nmulkey3/JunctionBox_42PinConversion/Docs/Requirements 42pin to 19pin converter board.pptx

42-Pin Junction Box Harness

19-Pin
A Receptacle

Signal
Conditioning
Board

R TR-A

R CL-A

R TR-B

R CL-B

R TR-C

R CL-C

CN3 – Molex 12pins
To 19-pin

Relay
FI-A

Relay
FI-B

Relay
FI-C

CN2 – 3pins Large

CN1 – Molex 12pins
From 42-pin

19-Pin
B Receptacle

19-Pin
C Receptacle

Part#

12V to 24V Converter

Vishay AC07000001502JAC00,
15kΩ, 5%, 7W

42-Pin Receptacle

## Slide 2

42-Pin Junction Box Harness Pin Map

42-Pin Connector | SS Junction Box Pins
1 | 19A-L
2 | CN1-2
3 | CN1-1
4 | CN1-4
5 | CN1-3
6 | CN1-6
7 | CN1-5
8 | 19B-L
9 | 19C-L
10 | CN1-10
11 | CN1-11
12 | CN1-7
13 | CN1-8
14 | CN1-9
15 | 19A-P, 19B-P, 19C-P
16 | 19C-M
17 | 19B-M
18
19
20
21 | 19A-A
22 | 19A-M
23
24
25 | CN1-11
26
27 | 19A-C, 19B-C, 19C-C
28 | 19B-A
29
30 | 19A-N
31 | 19B-N
32 | 19C-N
33 | 19A-N
34 | 19B-N
35 | 19C-A
36 | 19A-F
37 | 19B-F
38 | 19C-F
39 | 19C-N
40 | 19A-E
41 | 19B-E
42 | 19C-E

CN3 Pin | SS Junction Box Pins
1 | 19A-H
2 | 19A-G
3 | 19B-H
4 | 19B-G
5 | 19C-H
6 | 19C-G
7 | 19A-R
8 | 19B-R
9 | 19C-R
10 | 19A-J, 19B-J, 19C-J
11 | 19A-K, 19B-K, 19C-K
12

## Slide 3

Signal Conditioning Board Pin Outs

Pin | Signal
1 | Trip 1 (155V)
2 | Close 1 (155V)
3 | Trip 2 (155V)
4 | Close 2 (155V)
5 | Trip 3 (155V)
6 | Close 3 (155V)
7 | Fault Ind A (12V)
8 | Fault Ind B (12V)
9 | Fault Ind C (12V)
10 | 12V DC Power
11 | Gnd
12

CN1

Pin | Signal
1 | 12V DC Power
2 | Gnd
3 | 24V DC Power

CN2

Pin | Signal
1 | Trip A (24V)
2 | Close A (24V)
3 | Trip B (24V)
4 | Close B (24V)
5 | Trip C (24V)
6 | Close C (24V)
7 | Fault Ind A (24V)
8 | Fault Ind B (24V)
9 | Fault Ind C (24V)
10 | 24V DC Power
11 | Gnd
12

CN3

CN2-3 to CN3-10
Make a very wide trace to handle 5A continuous
