nmulkey3/JunctionBox_42PinConversion/Docs/Datasheets/Enclosure LP35 PCB Template.png

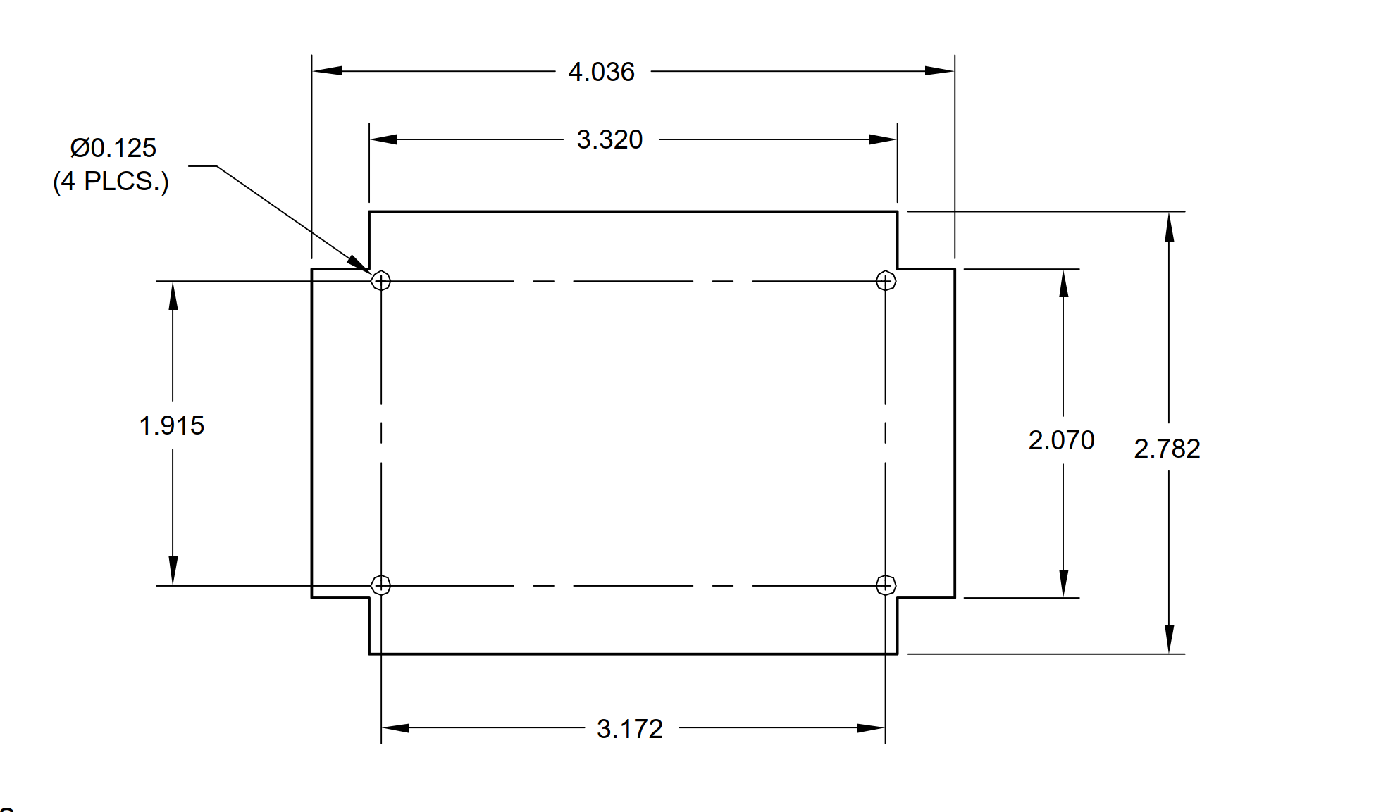
Docs/Datasheets/Enclosure LP35 PCB Template.png
