nmulkey3/JunctionBox_42PinConversion/Builds/Rev(-) 2021Nov22/42JxBx_Proto_eBOM_11082021.xlsx

42JxBx_Proto |  | Approved by Nick Mulkey | Approved on 11/08/2021 | Approved for PCBA 42JxBx_Proto Rev(-) 08Nov2021
Designator | Comment | Description | Footprint | Manufacturer | PartNumber | Quantity | Temp | Voltage | Power | PartNumber-CM | Alternate Allowed
C1, C2, C5, C7, C9, C11 | 100nF | CAP CER 10% 0603 | C0603N | AVX Corporation | 06035C104KAZ2A | 6
C3, C4, C6, C8, C10, C12 | 0.012uF | CAP CER 10% 0805 | C0805K | KEMET | C0805C123K5RACTU | 6
CN1, CN3 | 0039299183 | Connector Header Through Hole 18 position 0.165" (4.20mm) | 0039299183 | Molex | 0039299183 | 2
CN2 | 15-31-1036 | 3 Pin power connector | Molex_15-31-1036_0 | Molex | 15-31-1036 | 1
D1, D2, D3 | S1A-13-F |  | Micro_Commercial_DO-214AC_MFG |  | S1A-13-F | 3
K1, K2, K3 | DS2Y-S-DC24V |  | Panasonic_DS2Y-S-DC24V_0 |  | DS2Y-S-DC-24V-H350 | 3
R1, R2, R3, R4, R5, R6, R7, R8, R9, R10, R11,R12 | 10k | RES SMD 1/10W 0603 1%, RES SMD 1/10W 0603 0.1% | R0603N | Panasonic Electronic Components | ERA-8AEB103V | 12
R13, R14, R15, R16, R17, R18 | AC07000001502JAC00 |  | AC07000001502JAC00 |  | AC07000001502JAC00 | 6
U1, U2, U3, U4, U5, U6 | FOD817DSD | OPTOISOLATOR 5KV TRANSISTOR 4SMD | 4-SMD GullWing |  | FOD817DSD | 6
Do Not Populate
RTD2 is an Alternate to RTD1, but with a different Package. Only Populate RTD1 or RTD2, never both
Part Provided
Alternate Part
Updated Since Last Release
Special Install Instructions
