nmulkey3/JunctionBox_42PinConversion/Docs/Datasheets/Board Outline Enclosure - Potting Enclosure Body BX-3308BMB v1.dxf

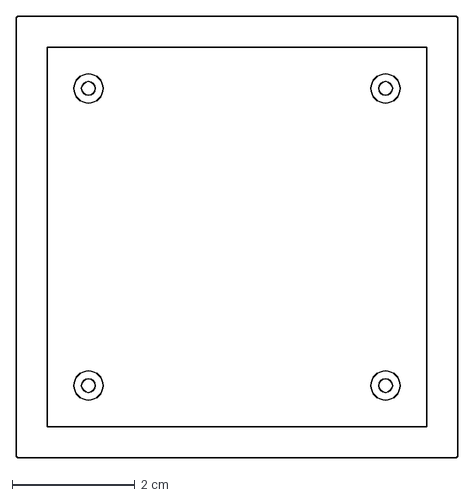
[picture p2: CAD file, 2021-11-09]
Docs/Datasheets/Board Outline Enclosure - Potting Enclosure Body BX-3308BMB v1.dxf
7.20 x 7.20 cm
