nmulkey3/JunctionBox_42PinConversion/Docs/Datasheets/Enclosure - LP35 PCB Template v1.dxf

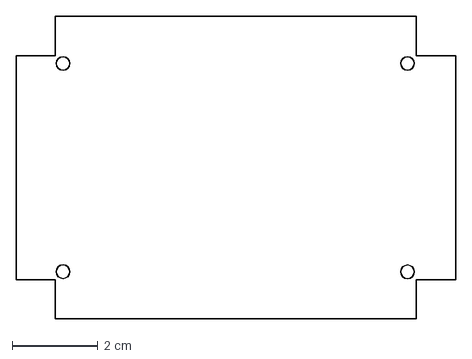
[picture p3: CAD file, 2021-11-09]
Docs/Datasheets/Enclosure - LP35 PCB Template v1.dxf
10.3 x 7.07 cm
