nmulkey3/JunctionBox_42PinConversion/(list of files, cad)

Other CAD files:
Docs/Datasheets/Enclosure - LP35 PCB Template v1.dwg
