nmulkey3/JunctionBox_42PinConversion/Junction Bo 42Pin Conv 2.pdf

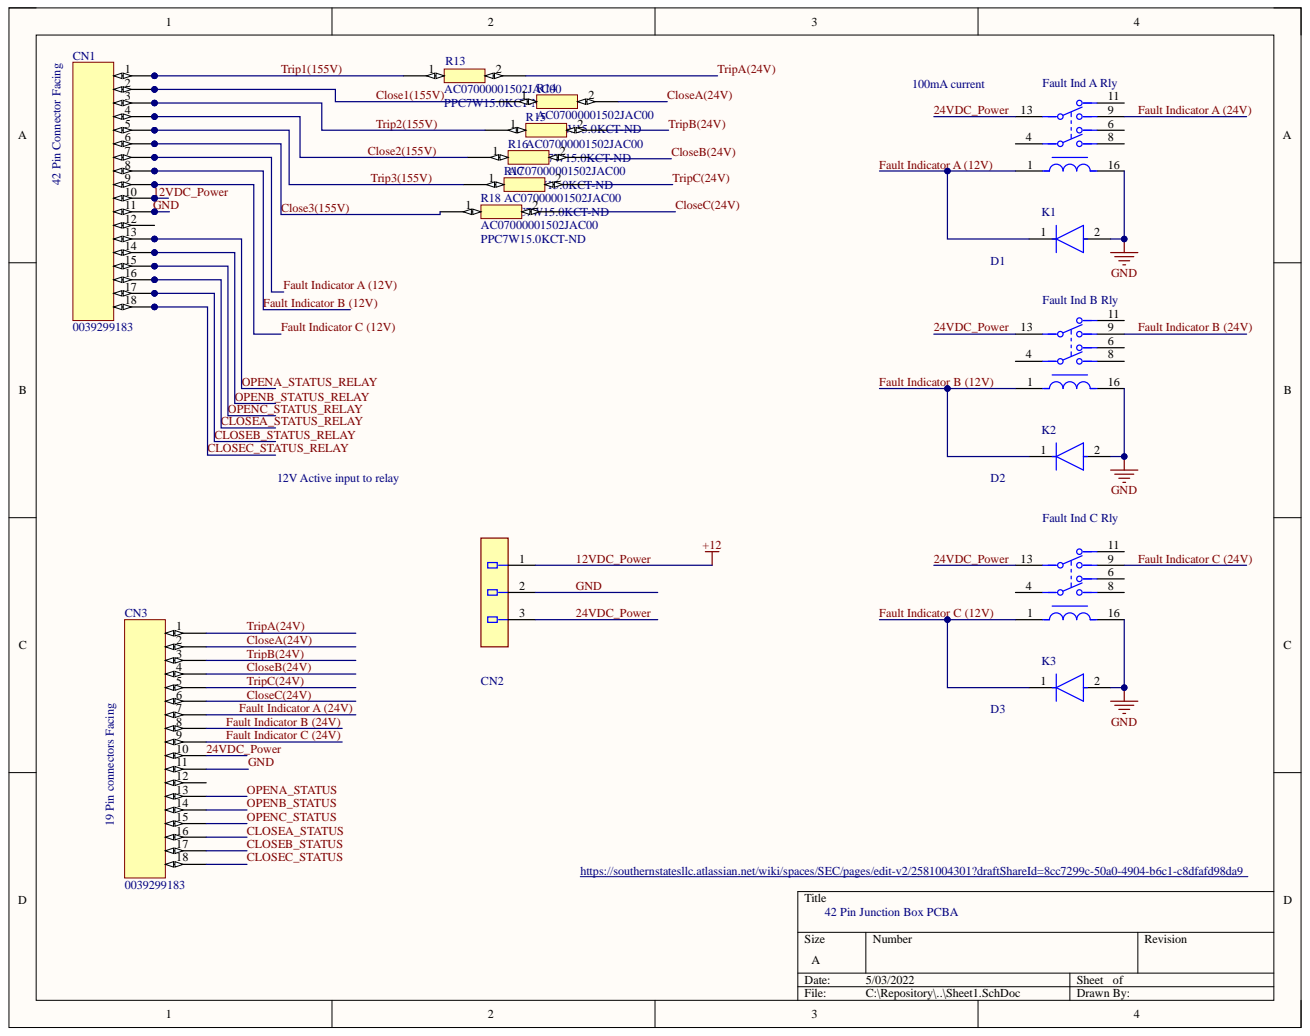
[picture p4: page 1]

Clos e1(155V )

Trip2(155V )

14
15
16
17
18 | F aul

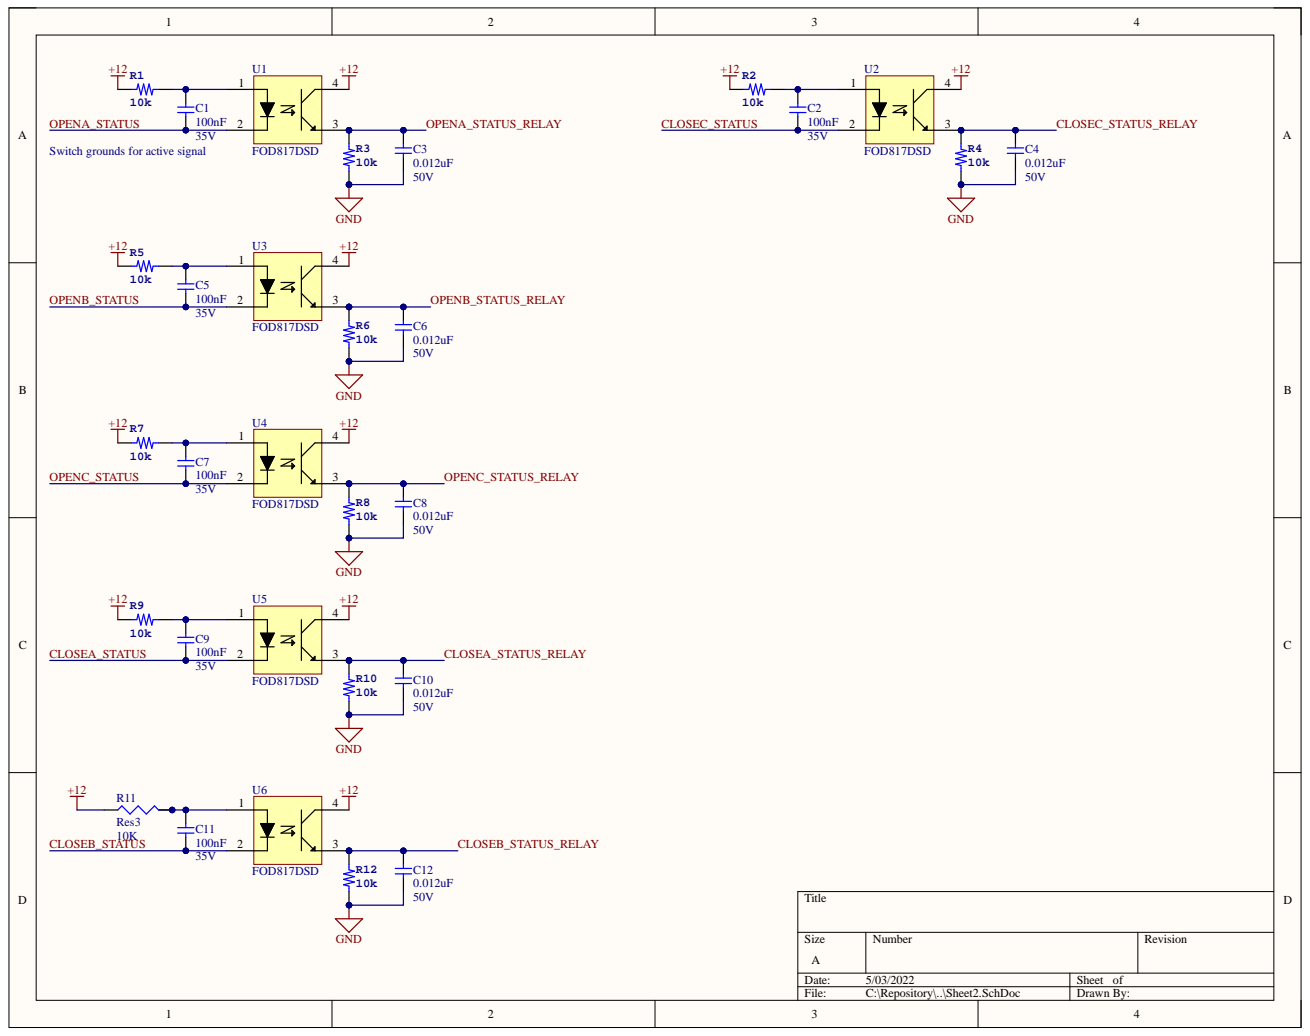
[picture p5: page 2]

OPENA_STATUS
Switch grounds for active signal

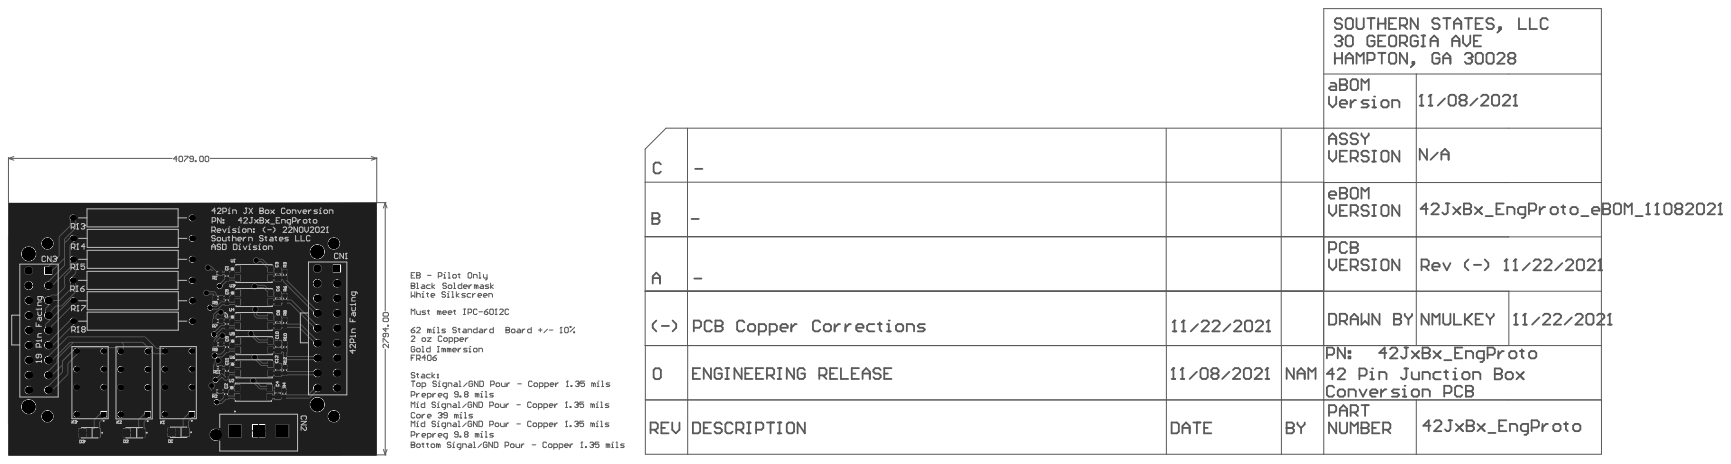
[picture p6: page 3]

Comment | Description | Designator | Footprint | LibRef | Quantity
100nF | CAP CER 10% 0603 | C1, C2, C5, C7, C9, C11 | C0603N | CAP_0603 | 6
0.012uF | CAP CER 10% 0805 | C3, C4, C6, C8, C10, C12 | C0805K | CAP_0805 | 6
0039299183 | Connector Header Through Hole 18 position 0.165" (4.20mm) | CN1, CN3 | 0039299183 | 0039299183 - 18 pin molex mini fit jr 5566 | 2
15-31-1036 | | CN2 | Molex_15-31-1036_0 | 15-31-1036 | 1
S1A-13-F | | D1, D2, D3 | Micro_Commercial_D O-214AC_MFG | FM2000GP | 3
DS2Y-S-DC24V | | K1, K2, K3 | Panasonic_DS2Y-S-DC24V_0 | DS2Y-S-DC24V | 3
10k | RES SMD 1/10W 0603 1%, RES SMD 1/10W 0603 0.1% | R1, R2, R3, R4, R5, R6, R7, R8, R9, R10, R12 | R0603N | RES_1/10W_0603_1% , RES_1/10W_0603_0.1 % | 11
Res3 | Resistor | R11 | J1-0603 | Res3 | 1
AC07000001502JAC00 | | R13, R14, R15, R16, R17, R18 | AC07000001502JAC00 AC07000001502JAC00 | | 6
FOD817DSD | OPTOISOLATOR 5KV TRANSISTOR 4SMD | U1, U2, U3, U4, U5, U6 4-SMD GullWing | | 108-00030-001 | 6
