nmulkey3/JunctionBox_42PinConversion/Builds/Rev(-) 2021Nov22/DWG - Assy.pdf

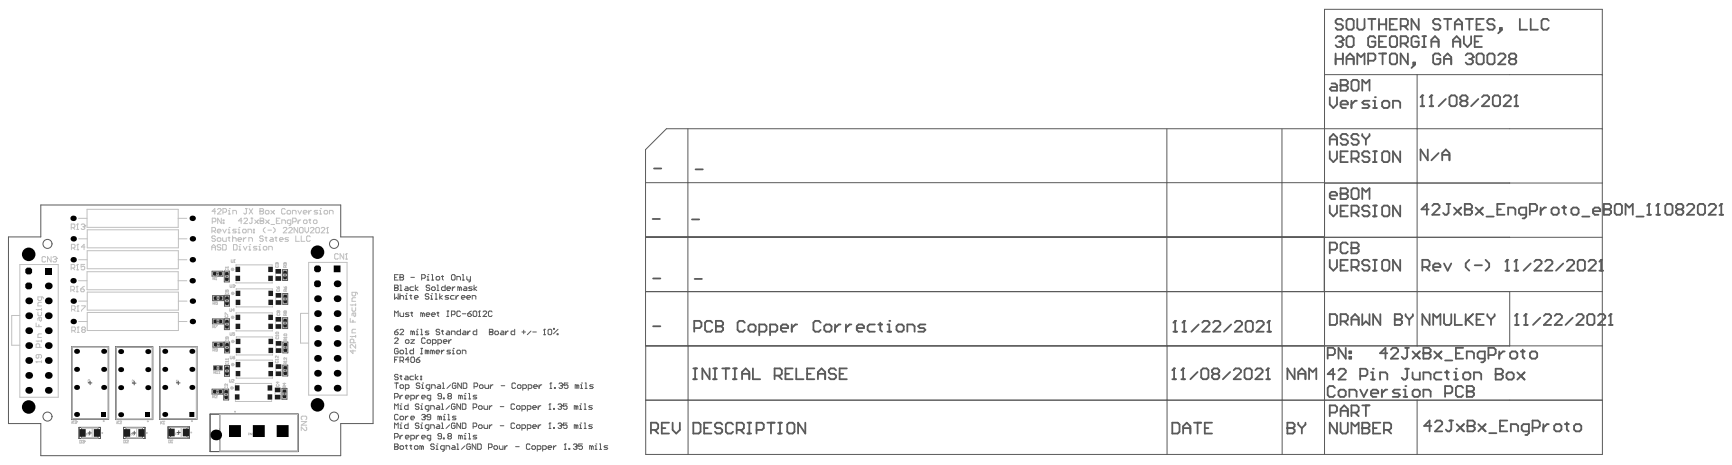
[picture p11: page 1]

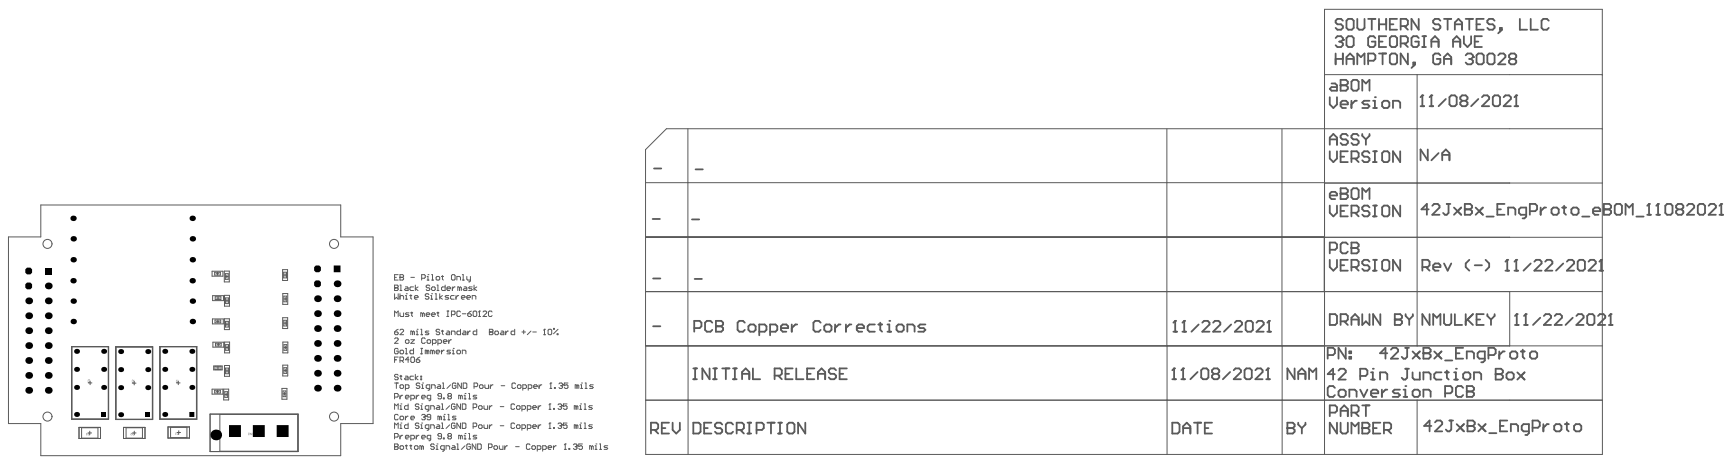
[picture p12: page 2]
