nmulkey3/JunctionBox_42PinConversion/Builds/Rev(-)/42JxBx_Proto Assy Drawings Rev (-).pdf

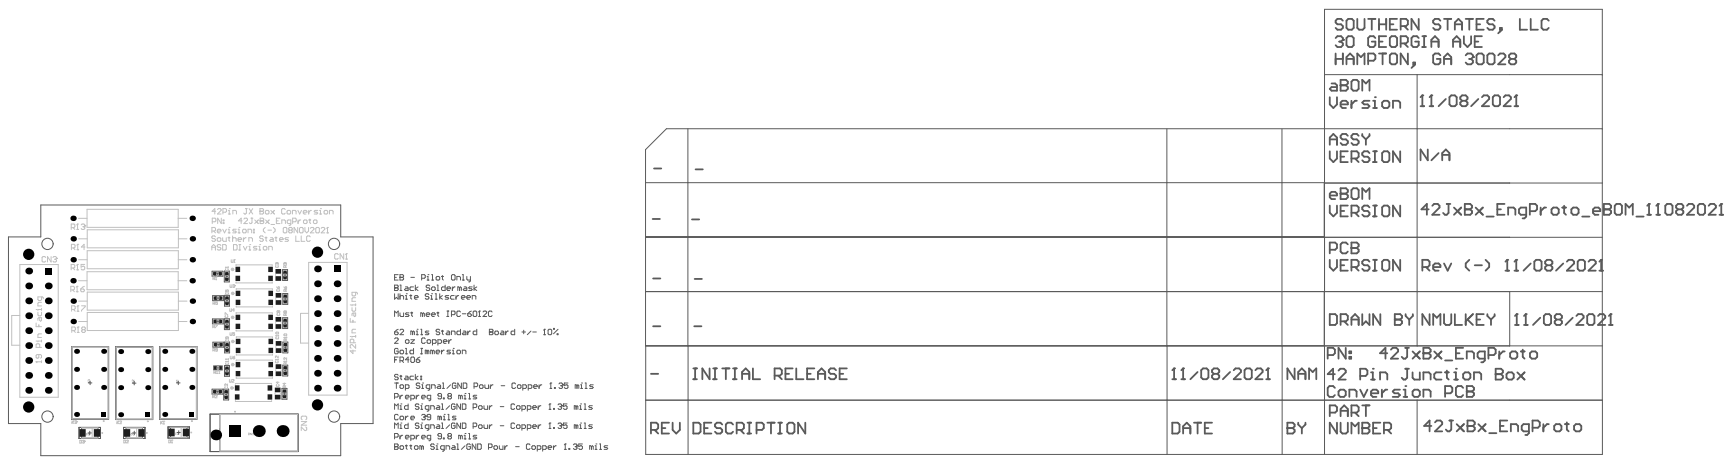
[picture p13: page 1]

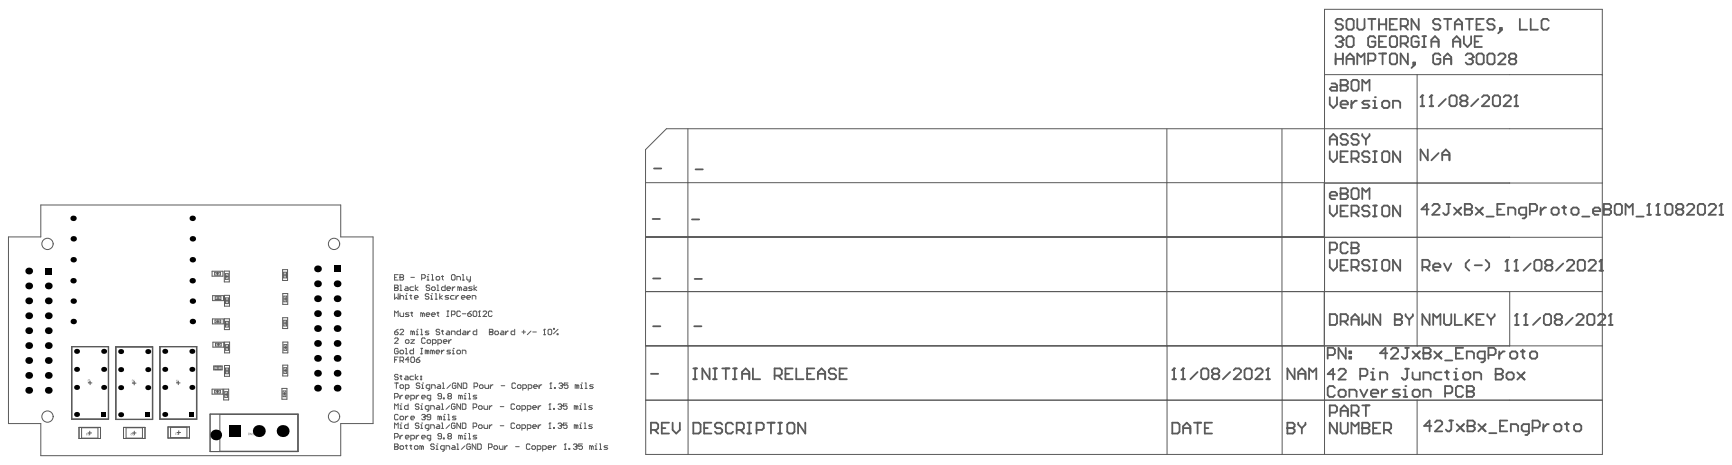
[picture p14: page 2]
