nmulkey3/JunctionBox_42PinConversion/(list of files, drawings)

Other design files:
42PinJunctionBox.PcbLib
42PinJunctionBox.SchLib
Junction Bo 42Pin Conv.PrjPcb
PCB1.PcbDoc
PcbLib1.PcbLib
Sheet1.SchDoc
Sheet2.SchDoc
