nmulkey3/JunctionBox_42PinConversion/Docs/Connector Wiring Diagram.xlsx

Req Doc | 42 Pin connector Name | 42 Pin connector | CN1-Name | CN1 | RTR-A | RCL-A1 | RTR-B1 | RCL-B1 | RTR-C1 | RCL-C1 | RLYA_CNTL | RLYB_CNTL | RLYC_CNTL | CN2 Name | CN2 | CN3 Name | CN3 | 19A | 19B | 19C
 | Trip 1 (155V) | 1 |  | 1 | 1 |  |  |  |  |  |  |  |  |  |  |  |  | L
 | Close 1 (155V) | 2 |  | 2 |  | 1
 | Trip 2 (155V) | 3 |  | 3 |  |  | 1
 | Close 2 (155V) | 4 |  | 4 |  |  |  | 1
 | Trip 3 (155V) | 5 |  | 5 |  |  |  |  | 1
 | Close 3 (155V) | 6 |  | 6 |  |  |  |  |  | 1
 | Fault Ind A (12V) | 7 |  | 7 |  |  |  |  |  |  | 1
 | Fault Ind B (12V) | 8 |  | 8 |  |  |  |  |  |  |  | 1 |  |  |  |  |  |  | L
 | Fault Ind C (12V) | 9 |  | 9 |  |  |  |  |  |  |  |  | 1 |  |  |  |  |  |  | L
 | 12V DC Power | 10 |  | 10 |  |  |  |  |  |  |  |  |  | 12 DC Power | 1
 | Gnd | 11 |  | 11
 |  | 12 |  | 12
 |  | 13
 |  | 14
 |  | 15 |  |  |  |  |  |  |  |  |  |  |  |  |  |  |  | P | P | P
 |  | 16 |  |  |  |  |  |  |  |  |  |  |  |  |  |  |  |  |  | M
 |  | 17 |  |  |  |  |  |  |  |  |  |  |  |  |  |  |  |  | M
 |  | 18
 |  | 19
 |  | 20
 |  | 21 |  |  |  |  |  |  |  |  |  |  |  |  |  |  |  | A
 |  | 22 |  |  |  |  |  |  |  |  |  |  |  |  |  |  |  | M
 |  | 23
 |  | 24
 |  | 25
 |  | 26
 |  | 27 |  |  |  |  |  |  |  |  |  |  |  |  |  |  |  | C | C | C
 |  | 28 |  |  |  |  |  |  |  |  |  |  |  |  |  |  |  |  | A
 |  | 29
 |  | 30 |  |  |  |  |  |  |  |  |  |  |  |  |  |  |  | N
 |  | 31 |  |  |  |  |  |  |  |  |  |  |  |  |  |  |  |  | N
 |  | 32 |  |  |  |  |  |  |  |  |  |  |  |  |  |  |  |  |  | N
 |  | 33 |  |  |  |  |  |  |  |  |  |  |  |  |  |  |  | N
 |  | 34 |  |  |  |  |  |  |  |  |  |  |  |  |  |  |  |  | N
 |  | 35 |  |  |  |  |  |  |  |  |  |  |  |  |  |  |  |  |  | A
 |  | 36 |  |  |  |  |  |  |  |  |  |  |  |  |  |  |  | F
 |  | 37 |  |  |  |  |  |  |  |  |  |  |  |  |  |  |  |  | F
 |  | 38 |  |  |  |  |  |  |  |  |  |  |  |  |  |  |  |  |  | F
 |  | 39 |  |  |  |  |  |  |  |  |  |  |  |  |  |  |  |  |  | N
 |  | 40 |  |  |  |  |  |  |  |  |  |  |  |  |  |  |  | E
 |  | 41 |  |  |  |  |  |  |  |  |  |  |  |  |  |  |  |  | E
 |  | 42 |  |  |  |  |  |  |  |  |  |  |  |  |  |  |  |  |  | E
 |  |  |  |  | 2 |  |  |  |  |  |  |  |  |  |  | Trip A (24V) | 1 | H
 |  |  |  |  |  | 2 |  |  |  |  |  |  |  |  |  | Close A (24V) | 2 | G
 |  |  |  |  |  |  | 2 |  |  |  |  |  |  |  |  | Trip B (24V) | 3 |  | H
 |  |  |  |  |  |  |  | 2 |  |  |  |  |  |  |  | Close B (24V) | 4 |  | G
 |  |  |  |  |  |  |  |  | 2 |  |  |  |  |  |  | Trip C (24V) | 5 |  |  | H
 |  |  |  |  |  |  |  |  |  | 2 |  |  |  |  |  | Close C (24V) | 6 |  |  | G
 |  |  |  |  |  |  |  |  |  |  | 2 |  |  |  |  | Fault Ind A (24V) | 7 | R
 |  |  |  |  |  |  |  |  |  |  |  | 2 |  |  |  | Fault Ind B (24V) | 8 |  | R
 |  |  |  |  |  |  |  |  |  |  |  |  | 2 |  |  | Fault Ind C (24V) | 9 |  |  | R
 |  |  |  |  |  |  |  |  |  |  |  |  |  | 12V DC Power | 3 | 24V DC Power | 10 | J | J | J
 |  |  |  |  |  |  |  |  |  |  |  |  |  |  |  | Gnd | 11 | K | K | K
 |  |  |  |  |  |  |  |  |  |  |  |  |  |  |  |  | 12
