nmulkey3/JunctionBox_42PinConversion/(commit log)

2021-11-09 Release for Quote - Rev(-) 42JxBx Eng Proto Rev(-) 08Nov2021
    [42JxBx_Proto_eBOM_11082021.xlsx, 42PinJunctionBox.PcbLib, 42PinJunctionBox.SchLib, Board Outline Enclosure - Potting Enclosure Body BX-3308BMB v1.dxf, Connector Wiring Diagram.xlsx, Enclosure - LP35 PCB Template v1.dwg, Enclosure - LP35 PCB Template v1.dxf, PCB Template XY positions.xlsx]
2022-05-27 completion of release and procured Rev (-)
    [42JxBx_Proto_eBOM_11082021.xlsx, 42PinJunctionBox.PcbLib, Junction Bo 42Pin Conv.PrjPcb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]
2022-06-30 inital commit, adding files to repo
    [Sheet1.SchDoc, Sheet2.SchDoc]
